mkseo90/present/(commit log)

2026-07-29 초기 커밋: 웹앱 + 펌웨어 스켈레톤 + BLE 프로토콜 v0.1
    - app/: Web Bluetooth 제어 웹앱 (시뮬레이터 모드 포함)
    - firmware/: XIAO nRF52840 Sense 스케치, 한글 11,172자 폰트 (Galmuri7)
    - PROTOCOL.md: NUS 기반 텍스트 라인 프로토콜
2026-07-29 README: 배포 URL을 mkseo90/present로 반영
2026-08-10 앱: PWA 매니페스트/아이콘, 전체화면 버튼, 주인 정보 표시 추가
    - manifest.json + 아이콘(192/512) → 안드로이드 홈화면 추가 시 주소창 없는 전체화면
    - 전체화면 토글 버튼 (Fullscreen API 미지원 브라우저에선 자동 숨김)
    - INFO의 owner/serial 파싱해 설정 탭 정보 카드에 표시
2026-08-10 앱: 터치 기기에서 첫 탭에 자동 전체화면 전환
2026-08-11 앱: 펌웨어 버전 기반 UI 분기 (GREEN/RGB 완드)
    - fw < 1.0.0 → 색 선택 숨김 + 초록 미리보기 (GREEN 완드)
    - fw >= 1.0.0 또는 판별 불가(sim) → 풀컬러 UI
    - 연결 해제 시 풀컬러 UI로 복귀
2026-08-19 OTA: v0.0.2 펌웨어 패키지 웹 배포
2026-08-19 보안: DFU PIN 잠금 + 비공개 값(secrets.h) 분리, OTA zip 교체
2026-08-19 PROTOCOL: DFU 잠금 명령·ERR 7 문서화
2026-08-19 비상 대응: LED 7개(D0~D6) 반영, OTA 보류 및 공개 zip 제거
2026-08-19 WIP: BLE 수신 시 프리즈 디버깅 스냅샷 (검증 전 — 브링업 브랜치)
    - USE_FS=0 격리 실험 빌드 (LittleFS 용의자)
    - 디버그: [hb] 하트비트, [reply>] 추적, TEST on/off/chase, 150ms 유휴 파싱
    - firmware/test-bleuart: 순정 최소 에코 (정상 동작 확인용)
    - HANDOFF.md: 전체 상황·다음 단계 인수인계
2026-08-19 펌웨어: BLE 수신 즉시 프리즈 해결 + notify 유실 해결 + 브링업 진단 명령
    원인이 서로 무관한 버그 두 개였다.
    1) 수신 즉시 전체 사망 = handleLine() 스택 오버플로
    imgRx = {} 는 6KB 임시객체를 만들고, GCC가 그 자리를 함수 프롤로그에서
    미리 잡는다. loop 태스크 스택은 256*4 = 4096B뿐이라 IMGB 분기를 타는지와
    무관하게 진입 즉시 스택이 넘쳤다. 실측(objdump): 프레임 6200B -> 48B.
    ImgRx의 멤버 기본값(NSDMI)도 제거해 다시 ImgRx{} 를 못 쓰게 했다.
    2) 긴 응답이 격번으로 유실 = SoftDevice HVN(notify) 큐가 1칸
    코어가 빈 칸을 100ms만 기다린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
2026-08-19 앱: 미리보기를 펌웨어와 같은 비트맵 폰트로 교체, MTU 23 대응, 단색 UI 기본값화
    미리보기 글자가 뭉개지던 원인: app이 "8px Galmuri7"을 요청하는데 app/에 폰트도
    @font-face도 없어 Malgun Gothic으로 폴백됐고, 아웃라인 폰트를 8px로 래스터화해
    알파 임계값으로 자르니 한글이 죽이 됐다. 폰트를 넣어도 캔버스 래스터화라
    기기 출력과 일치하지 않는다.
    - font8x8.js 추가: 펌웨어 font8x8.h / font8x8_kr.h 와 동일한 비트맵 테이블
    (89,376바이트가 헤더와 바이트 단위로 일치하는 것을 검증). 이제 미리보기가
    기기 출력과 픽셀 단위로 같다. 펌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
2026-08-19 도구·문서: BLE 자체검증/웹앱 브리지/폰트 변환 추가, 브링업 명령과 검증 결과 기록
    도구:
    - firmware/tools/ble_selftest.py: 폰 없이 PC에서 프로토콜 왕복 검증
    (basic / fs / persist / pov / clean)
    - firmware/tools/webapp_bridge.py: Web Bluetooth 기기 선택창을 우회해
    웹앱 코드를 그대로 실기기에 붙여 시험하는 개발용 하네스
    - firmware/tools/gen_font_js.py: 펌웨어 폰트 헤더를 app/font8x8.js 로 변환
    (PIL/TTF 없이 .h 파싱만으로 재생성 가능)
    문서:
    - HANDOFF: 프리즈 원인(스택 오버플로) 실측 근거, notify 큐 원인, 실기기 검증
    결과표, LED 전체 미점등 사례(원인=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
2026-08-19 주인 정보를 소스에서 기기 플래시로 (secrets.h 불필요)
    이름을 소스에 두면 (1) 공개 저장소에 사람 실명이 남고 (2) gitignore된 파일을
    PC마다 들고 다녀야 한다. 주인 정보는 보드별 데이터이므로 보드 안에 두는 것이 맞다.
    - SETOWNER <이름> <시리얼> <색> / CLROWNER 명령 추가.
    LittleFS 의 /owner 에 저장되어 재부팅·재플래시 후에도 유지된다
    - secrets.h 를 __has_include 로 선택사항화 → 새 클론이 파일 없이 바로 빌드된다
    - 우선순위: 기기 주입값 > secrets.h 의 OWNERS[] 표(있으면) > 없음
    - INFO / 부팅 크레딧이 런타임 레코드를 본다
    - firmware/tools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
2026-08-19 앱: 미리보기 라벨의 완드 색 문구 제거, 기본 프리셋 예시 제거
    - 라벨을 "잔상 미리보기"로 단순화. 완드 색은 미리보기 도트 색으로 이미 보이므로
    글자로 반복할 필요가 없다. 기기 한도 초과 경고는 그대로 유지.
    미사용이 된 COLOR_NAMES / monoColorLabel() 도 함께 제거
    - 보내기 프리셋을 빈 목록에서 시작. 하드코딩된 송별 문구 예시 두 개를 지웠다
    (localStorage 에 저장된 사용자 프리셋은 건드리지 않는다)
    색·LED개수 반영은 그대로 동작함을 확인: color=3399FF leds=5 를 받으면
    도트 색과 미리보기 행 수가 따라간다.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
2026-08-19 기기 이름을 "<주인이름>의 LED" 로 (여러 대 구분)
    완드를 여러 개 동시에 켜면 전부 POV-STICK 으로 보여 구분이 안 됐다.
    주인 정보는 이미 기기에 주입되므로 그 이름을 광고 이름에 쓴다.
    미주입 보드는 POV-STICK 을 유지해 새 보드도 항상 찾을 수 있게 했다.
    펌웨어:
    - composeBleName(): "<이름>의 LED". 이름은 스캔 응답 AD 필드(29바이트)에 들어가므로
    넘치면 UTF-8 문자 경계를 지키며 자른다
    - setName() 은 광고 시작 전에 불려야 하고, 이름에 주인 이름이 필요하므로
    findOwner() 를 setupBle() 안(Bluefruit.begin() 직후)으로 옮겼다.
    findOwner() 는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
2026-08-19 보안: LESC 페어링(Just Works)+본딩 적용, 미암호화 명령 ERR 8 거부
    - REQUIRE_PAIRING 1: 연결 0.6초 후 기기가 보안 요청, secured 전 명령 게이트
    - 코어 기본 파라미터가 이미 LESC(bond=1,lesc=1, nRF52840 CryptoCell) — 요청만 트리거
    - CLRBOND 명령(본딩 초기화), 연결 해제 시 secured 상태 리셋
    - PROTOCOL.md: ERR 8, 보안 절차, CLRBOND 문서화
    - 실기기(웹앱/Bluefy) 검증 전 — 문제시 REQUIRE_PAIRING 0
2026-08-19 앱: ERR 8(페어링 대기)을 alert 대신 조용한 INFO 재시도로 처리
2026-08-20 앱: 히든 관리자 모드 (로고 7번 탭으로 토글)
    - 잔상 속도 슬라이더(SET SPEED 0~30ms, 0=자동)
    - LED 테스트/배선 진단(PROBE) 버튼, 주인 주입 폼, 본딩·주인 삭제(확인창)
    - 원시 명령 입력(Enter 전송) — nRF Connect 없이 전 프로토콜 사용 가능
    - 일반 사용자에게는 완전히 숨김 (localStorage로 상태 유지)
2026-08-20 앱: 캐시버스터(?v=) 도입 — Pages 10분 캐시로 갱신 안 보이는 문제
2026-08-20 잔상 좌우반전 스위치(SET FLIP) + 광고 감시견(끊김 후 재광고 안 되는 문제)
    - cfg.flip: POV 컬럼 역순 출력, 플래시 저장. 앱 관리자 모드에 정/반전 버튼(?v=4)
    - advWatchdog: 연결 없음+광고 꺼짐 1초 지속 시 강제 재광고 (본딩 도입 후
    restartOnDisconnect 미동작 실기기 확인 — 재부팅 없이는 스캔 불가였음)
    [pov-wand.ino]
2026-08-20 IMU 스윙 감지 엔진 (내장 LSM6DS3, MODE_AUTO 완성)
    - 자이로 지배축 자동 선정 + ±120dps 임계 스윙 감지, 0.7초 무동작 시 대기 복귀
    - 방향 반전 포착 → 스트로크(반주기) 측정 → 스트로크당 1회, 시간의 70%로 그리기
    - 방향에 따른 자동 좌우반전 (왕복 양쪽에서 정상 판독, cfg.flip은 기준 반전용)
    - IMU 조회 명령(튜닝용), MODE_POV는 기존 수동 연속출력 유지
    [pov-wand.ino]
2026-08-20 OLED 주인이름 표시 + 실제 배터리 측정
    - 자체 SSD1306 미니 드라이버 (주소 0x3C 자동탐지, 없으면 비활성) — 우리 8x8
    비트맵 폰트로 한글 이름 2배 확대 표시 + 시리얼 + 배터리% + 연결상태
    - 잔상/테스트 중엔 OLED 갱신 중단 (I2C가 POV 타이밍 방해 금지)
    - readBattery(): VBAT 분압 실측 (3.3~4.15V -> 0~100%), INFO/OLED/앱에 반영
    - 주의: 확장보드 I2C(D4/D5)와 LED 채널 충돌 — 핀맵 이사(A안) 확정 대기
2026-08-20 OLED: 배터리 텍스트 → 채움형 아이콘(+% 숫자)
2026-08-20 OLED: BLE 상태를 아이콘으로 (전파=대기, BT+…=페어링, BT+✓=연결)
2026-08-20 핀맵 A안 전환: LED=D0,D2,D6~D10 / 버튼=확장보드 D1 (PINMAP_LEGACY로 구형 유지 가능)
2026-08-20 핀맵 원복(D0~D6, 버튼 D10) — 부저 물리 제거로 소음 해결, 사용자 결정
2026-08-20 ③안 확정: OLED 비활성(USE_OLED 0, 코드 보존) — LED D0~D6 유지, 버튼은 D10 별도 택트
2026-08-20 톡톡(더블탭) 제스처로 슬롯 전환 — 물리 버튼 없이 (IMU 가속도 스파이크 2회/700ms)
2026-08-20 탭 조건 강화 + 기본 소유자 + 앱 시작화면 메시지 리스트
    - 톡톡 전환: (1)멈춤 상태(스윙 아님+300ms 무동작) AND (2)탭 2회 모두 충족 시만
    - 펌웨어 기본 소유자: USER / No.000/000 / 00FF66 (SETOWNER로 덮어씀)
    - 앱: 보관함이 시작 화면, 기본 메시지 3종(소유자이름·Hello world!·그동안 감사했습니다)
    즉시 표시 — 소유자 이름은 INFO 수신 시 실제 주인으로 치환(캐시), 표시/저장 버튼 (?v=5)
2026-08-20 기본 메시지를 기기 슬롯 시딩으로 이전 (앱 하드코딩 제거)
    - 펌웨어: 최초 부팅 1회 슬롯 1~3 시딩(소유자이름/Hello world!/그동안 감사했습니다),
    /seeded 마커로 사용자 삭제·수정 존중
    - 앱: 시작 화면은 빈 보관함 + 안내 문구, 연결 시 LIST로 기기 내용 표시 (?v=6)
    [pov-wand.ino]
2026-08-20 OLED 공존 모드: 부팅 즉시+대기 중 10초마다만 그림, I2C를 D4/D5 LED와 시분할(그릴 때만 점유)
2026-08-20 OLED 노이즈 수정: 갱신마다 풀 재초기화 + 대기 물결에서 SCL(D5) 채널 상시 LOW
    [pov-wand.ino]
2026-08-20 OLED 공존 v2: 대기 중 D4/D5 정지(화면 항상 깨끗) + 스윙 종료 즉시 복구, POV 중엔 7줄 전부
2026-08-20 대기 상태: OLED 있으면 LED 전체 소등(화면이 대기 표시 담당), 물결은 OLED 없는 구성 전용
2026-08-21 OLED 부팅 노이즈 수정: 표시 켜기 전 GDDRAM 클리어 + 모드 무관 부팅 첫 화면 강제 렌더
    [pov-wand.ino]
2026-08-21 부팅 시 모드는 항상 자동(AUTO) — pov/idle은 세션용 상태로만
2026-08-21 보관함 안내 문구: 버튼 → 기기 톡톡 터치 (톡톡 제스처 반영), ?v=7
2026-08-21 안내 문구: 기기를 두번 터치하면 (?v=8)
2026-08-21 톡톡 감지를 LSM6DS3 하드웨어 더블탭 엔진으로 교체 + 정지 게이트를 '직전 정지' 래치로
2026-08-21 톡톡 디버그 로그: TAP_SRC/정지게이트/슬롯 전환
2026-08-21 만든이에 케이스 준혁 추가 (?v=9)
2026-08-21 폰트 확장: 한글 자모 + 기호 84자 (FONT8_EXT)
    - ㅋㅋ/ㅎㅎ/ㅠㅠ 자모 51자 + ♥★♪←→ 등 기호 33자 (Galmuri7에서 추출)
    - 펌웨어 glyphFor 확장 테이블 조회, 앱 미리보기 동일 테이블 (?v=10)
    - gen_font_js.py 파서가 주석 속 배열명에 낚이던 버그 수정
    [gen_font.py, gen_font_js.py, pov-wand.ino]
2026-08-21 전체화면 버튼 상시 표시 — 능력 사전판정 대신 클릭 시 시도, 실패 사유는 통신 로그로 (?v=11)
2026-08-21 입력창 자동완성·교정 비활성 — iOS '독서 목록' 제안 바 제거 (?v=12)
2026-08-21 캐시버스터 v13로 정정 (중간 bump 유실 — 폰트확장/전체화면/자동완성 변경분 반영 보장)
2026-08-21 기호 키보드(12종, 커서 삽입) + iOS 스마트따옴표/원화기호 글리프 추가 (EXT 89자, ?v=14)
2026-08-21 입력창을 contenteditable로 교체 — iOS '독서 목록' 제안 바 원천 차단 (?v=15)
2026-08-24 빌드 시각 스탬프 (설정 탭 정보 카드) + stamp_app.py 배포 도구 (v16, 빌드 08/24 17:26)
2026-08-24 입력 중 자동 스크롤 — 키보드/주소창이 화면을 먹어도 미리보기·입력창 확보
2026-08-24 독서목록 바 원인 이분탐색용 최소 실험 페이지
2026-08-25 스윙 감지 문턱 120→70dps + SET SWING 런타임 튜닝 + 관리자 민감도 슬라이더 (빌드 08/25 14:39, v18)
2026-08-25 잔상 방향 실시간 IMU 보정(수동모드 포함) + AUTO 모드도 SET SPEED 고정간격 사용
2026-08-25 수동 잔상 스윙 반동기화: 방향 반전 시 프레임 중단 + 문장 사이 빈 틈(1/3폭) + sw.dir 우선
2026-08-26 입력 자동 스크롤 목표를 입력창으로 — 최상단 스크롤이 Bluefy 북마크 바를 드러내던 문제 (진범 확정)
2026-08-26 Bluefy 북마크 바 근본 수정: 키보드 열림 시 웹뷰 창 자체를 아래로 고정 (내부 스크롤이 아닌 창 스크롤이 관건이었음, v20)
2026-08-26 탭바·헤더 드래그로 창 끌림 차단(touch-action+overscroll) + 전체화면 자동 재진입(키보드로 풀린 뒤 다음 탭에서 복귀, v21)
2026-08-26 v21 회귀 수정: header/nav touch-action:none 제거(iOS에서 버튼 click을 먹던 유력 원인) + 터치 target 텍스트노드 정규화(⛶ 자동진입-토글 상쇄 방지, v22)
2026-08-26 전체화면 자동복귀 가드를 키보드 실측으로 교체 + iOS 잔류 포커스 정리 (kbOpen 잠김/포커스 안풀림으로 시도가 영영 차단되던 버그, v23)
2026-08-26 전체화면 실패 사유를 화면 토스트로 표시(사후 진입확인 + API 지원현황, 2연속 실패 시 자동재시도 중단, v24)
2026-08-27 전체화면 API 없는 브라우저(Bluefy 실기기 채증)에서는 ⛶ 버튼·자동시도·토스트 비활성 — Bluefy 자체 Full-Screen Mode 사용 안내 (v25)
2026-08-27 선택창 없는 재연결(getDevices) + 페이지 로드 시 자동 재연결 + 연결실패 무반응 대신 토스트 — Bluefy 전체화면 모드가 페이지를 재로드하고 피커를 못 띄우는 문제 대응 (v26)
2026-08-27 입력 중 스크롤 기준을 미리보기로 복원(북마크 바 진범 오인으로 바꿨던 것) + 창 고정폭 72→56px로 미리보기 잘림 방지 (v27)
2026-09-04 BOOTDFU 명령(케이스 조립 후 리셋 없이 부트로더 진입) + 감시 플래셔 firmware/tools/flash.py 정식 편입 + HANDOFF를 08-27 상태로 갱신(집 PC 환경셋팅 포함)
